BpAAP/CanSat2019/designs/CanSatv1/Component Dimensions and Masses.xlsx

Component | Dimensions | Mass (g) |  | Density (g/mm^3)
Arduino ZeroMKR | 65x25x10 | 21.9 |  | 0.001347692308
barometer | 6.1x4.7x8.2 | 5 | approx | 0.02126808851
Temperature Sensor | 4.95x35x25.5 | 2 | approx | 0.0004527063351
GPS | 6.5x35x25.5 | 8.5 |  | 0.001465201465
Transceiver | 29x25x4 | 3.1 |  | 0.001068965517
Accelerometer | 1.6x7.6x13.2 | 3 | approx | 0.01869019139
Parachute Mechanism |  | 25 | approx
Battery | 46.5x24.5x15.5 | 45 |  | 0.00254836586
Misc Mass |  | 25
 |  | 138.5 |  |  | Average Density | 0.006691601626
