BpAAP/CanSat2019/CanSatFileForNewPrintMaterial.stl

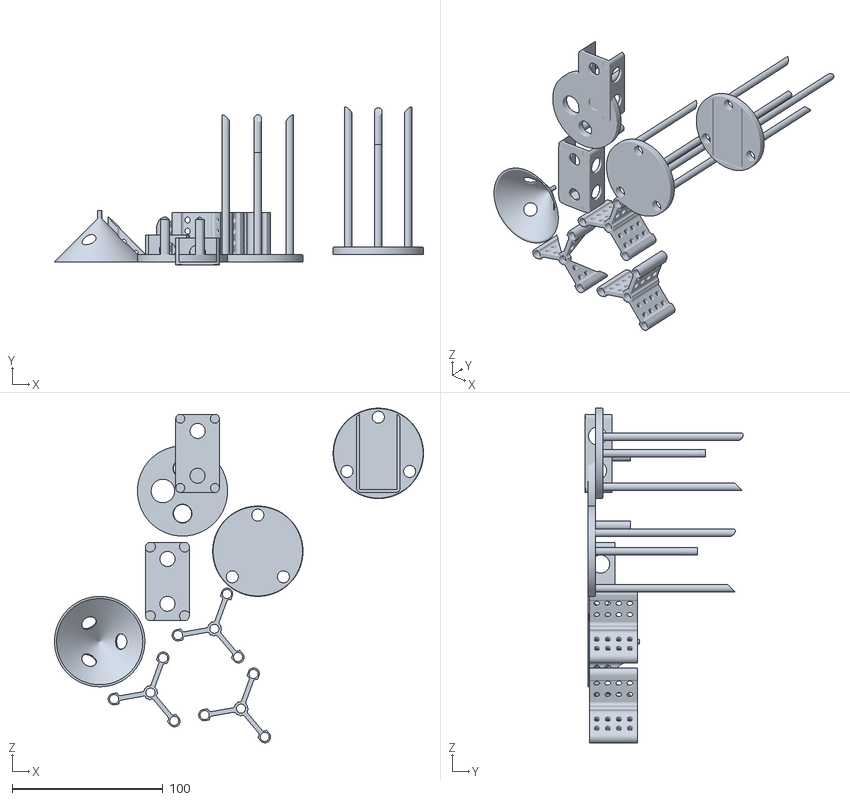
[picture p18: CAD file, 2020-03-06]
CanSatFileForNewPrintMaterial.stl
245.0 x 105.2 x 222.2
