BpAAP/CanSat2019/(list of files, cad)

Other CAD files:
CanSat Disassembled Version 2.f3d
CanSat_MK.2 v2 - Disassembled for 3d printing v2.f3d
CanSat_MK.2 v2 v12.f3z
CanSat_MK.2 v2 v7.f3z
CanSat_MK.2 v2.f3d
designs/CanSatv1/9V Battery v1.f3d
designs/CanSatv1/Accelerometer v1.f3d
designs/CanSatv1/ArduinoZeroMKR v1.f3d
designs/CanSatv1/Assembled v7.f3z
designs/CanSatv1/Barometer v1.f3d
designs/CanSatv1/BottomLid v4.f3d
designs/CanSatv1/GPS v1.f3d
designs/CanSatv1/Main Body v5.f3d
designs/CanSatv1/Temperature Sensor v1.f3d
designs/CanSatv1/Top Lid v5.f3d
designs/CanSatv1/Top Top v4.f3d
designs/CanSatv1/Transciever v1.f3d
