BpAAP/CanSat2019/ProposedCanSatv0_1.pdf

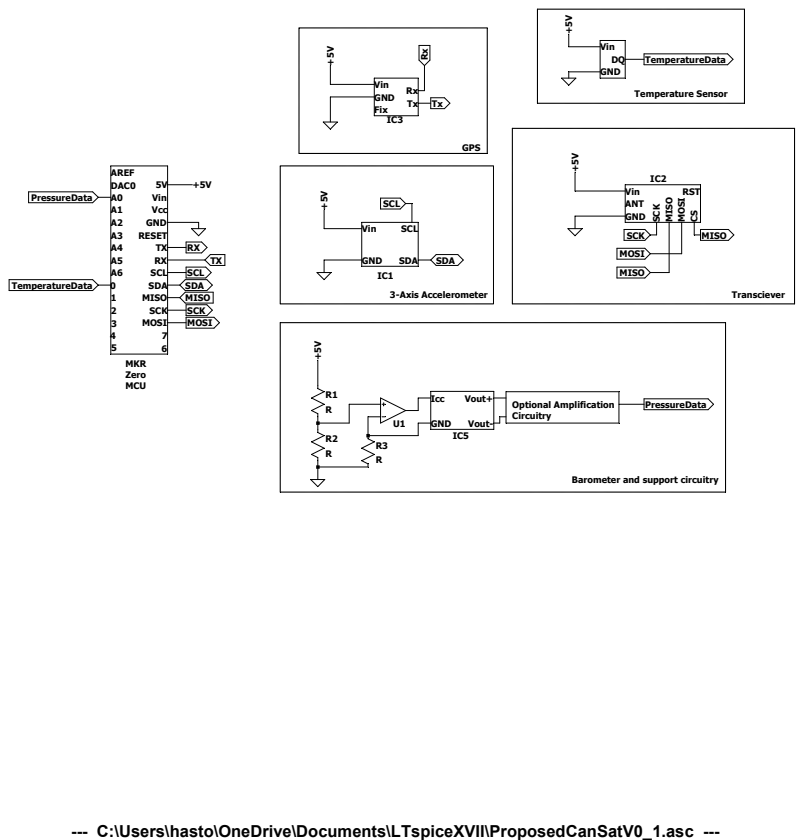
[picture p19: page 1]

GND SCK MISO MOSI CS

Barometer and support circuitry

--- C:\Users\hasto\OneDrive\Documents\LTspiceXVII\ProposedCanSatV0_1.asc ---
