BpAAP/CanSat2019/(commit log)

2020-01-03 One potential design for the case as requested
    [Proposed design v2 (Benedek).f3d]
2020-01-08 First design for the design review
    [BottomLid v3.f3d, Main Body v4.f3d, Top Lid v4.f3d, Top Top v3.f3d]
2020-02-20 Added temperature sensor
    Can return float value of measured temperature
2020-02-21 Accelerometer program TESTED
    Demo example of that gets accelerometer data. Tested that it works but requires modification to store and/or transmit
2020-03-05 Untested temperature sensor module.
    Note: Needs to be called by an external main function
2020-03-06 Temperature sensor program now tested and working
2020-03-16 Module tests
    GPS - working, getting accurate location, not saving
    SD - simple read write test
    Servo - simple sweep example test
2020-03-16 Libraries supporting the temperature sensor
